d008/CCA/parts.xlsx

LABEL on PCB | DIGIKEY PART # |  | Notes
V_REF | AD587KNZ-ND | IC VREF SERIES 10V 8DIP | voltage regulator to ensure 10V to the bridge
C1,C2 | 478-6065-ND | CAP TANT 47UF 20V 10% RADIAL | noise reduction
+/-15VDC | ED2741-ND | TERMINAL BLOCK 3.5MM 3POS PCB | screw terminals for wire leads
NSTAP, OUTPUT | ARF2037-ND | CONN BNC JACK R/A 75 OHM PCB | BNC connectors for the sensor and the output signal
C3, C5, C6 | 399-13634-1-ND | CAP TANT 1UF 5% 35V RADIAL | noise reduction
C4 | 495-5055-1-ND | CAP FILM 0.1UF 5% 100VDC RADIAL | noise reduction
IN-AMP | AD8429ARZ-ND | IC OPAMP INSTR 3.5MHZ 8SOIC | The amplification is set by R_GAIN, where R_GAIN = 6 kOhm/(Gain -1)
R_GAIN | 15.0XBK-ND | RES 15 OHM 1/4W 1% AXIAL | NSTAPs typically use a gain of ~400 but feel free to experiment and choose what works best for range of data acquisition
L1, L2 | M10080-ND | FIXED IND 1UH 1.07A 70 MOHM TH | noise reduction
R1, R2 | A105892CT-ND | RES 49.9 OHM 1/4W 0.1% AXIAL | noise reduction
R_TOP_1, R_TOP_2 | 3.3KADCT-ND | RES 3.3K OHM 1/4W 0.1% AXIAL | top resistors of the wheatstone bridge -- 3.3k Ohm was determined by trial and error (want a value high enough that the wire doesn't burn but low enough to be sensitive )
R_BAL | 180ADCT-ND | RES 180 OHM 1/4W 0.1% AXIAL | The total balance resistance is (R_BAL + TRIMPOT) so for our case we used 180 ohm + (5 to 200 ohm)
TRIMPOT | 490-2879-ND | TRIMMER 200 OHM 0.5W TH | The same series also have 50, 100 ohm trim pots available
- | 285-1760-ND | PWR SPLY MEDICAL +15V/-15V 15W | this was the AC/DC converter we used
