d008/CCA/NSTAP.brd

## EAGLE design NSTAP.brd (2020-06-23)

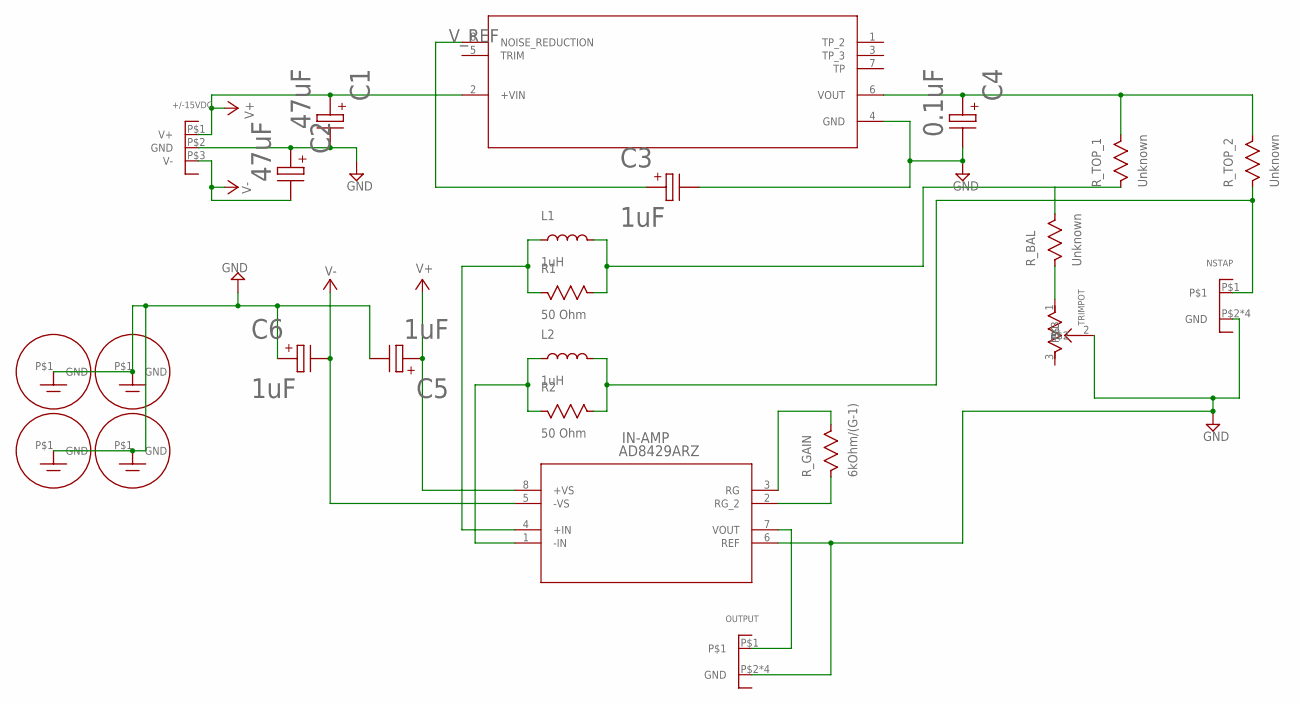
[picture p1: schematic NSTAP.sch]

Parts:
+/-15VDC: CONNECTOR_3COND""; SCREW_TERM3X-OST
C1, C2: 47uF; BRD_0075X050-P
C3, C5, C6: 1uF; BRD_0075X025-P
C4: 0.1uF; BRD_0075X050-P
IN-AMP: AD8429ARZ; R_8
L1, L2: 1uH; BRD_0075X150
NSTAP: CONNECTOR_COAXAMPHENOL-2037; BNC_AMPHENOL
OUTPUT: CONNECTOR_COAXAMPHENOL-2037; BNC_AMPHENOL
R1, R2: 50 Ohm; BRD_0075X100
R_BAL: Unknown; BRD_0075X100
R_GAIN: 6kOhm/(G-1); BRD_0075X100
R_TOP_1, R_TOP_2: Unknown; BRD_0075X100
TRIMPOT: TRIM_POT
U$1, U$2, U$3, U$4: GND-SCREW4MM; GND-SCREW_4MM
V_REF: AD587KNZ; N_8

Connections:
GND: +/-15VDC.P$2 (GND), C1.P$2, C2.P$1, C3.P$2, C4.P$2, C5.P$2, C6.P$1, IN-AMP.6 (REF), NSTAP.P$2 (GND), NSTAP.P$3 (GND), NSTAP.P$4 (GND), NSTAP.P$5 (GND), OUTPUT.P$2 (GND), OUTPUT.P$3 (GND), OUTPUT.P$4 (GND), OUTPUT.P$5 (GND), TRIMPOT.2, U$1.P$1, U$2.P$1, U$3.P$1, U$4.P$1, V_REF.4 (GND)
unnamed: C3.P$1, V_REF.8 (NOISE_REDUCTION)
unnamed: R_BAL.P$1, TRIMPOT.1
unnamed: IN-AMP.3 (RG), R_GAIN.P$2
unnamed: IN-AMP.2 (RG_2), R_GAIN.P$1
unnamed: IN-AMP.7 (VOUT), OUTPUT.P$1
unnamed: IN-AMP.4 (+IN), L1.P$1, R1.P$1
unnamed: IN-AMP.1 (-IN), L2.P$1, R2.P$1
unnamed: L2.P$2, NSTAP.P$1, R2.P$2, R_TOP_2.P$1
unnamed: C4.P$1, R_TOP_1.P$2, R_TOP_2.P$2, V_REF.6 (VOUT)
unnamed: L1.P$2, R1.P$2, R_BAL.P$2, R_TOP_1.P$1
V+: +/-15VDC.P$1 (V+), C1.P$1, C5.P$1, IN-AMP.8 (+VS), V_REF.2 (+VIN)
V-: +/-15VDC.P$3 (V-), C2.P$2, C6.P$2, IN-AMP.5 (-VS)

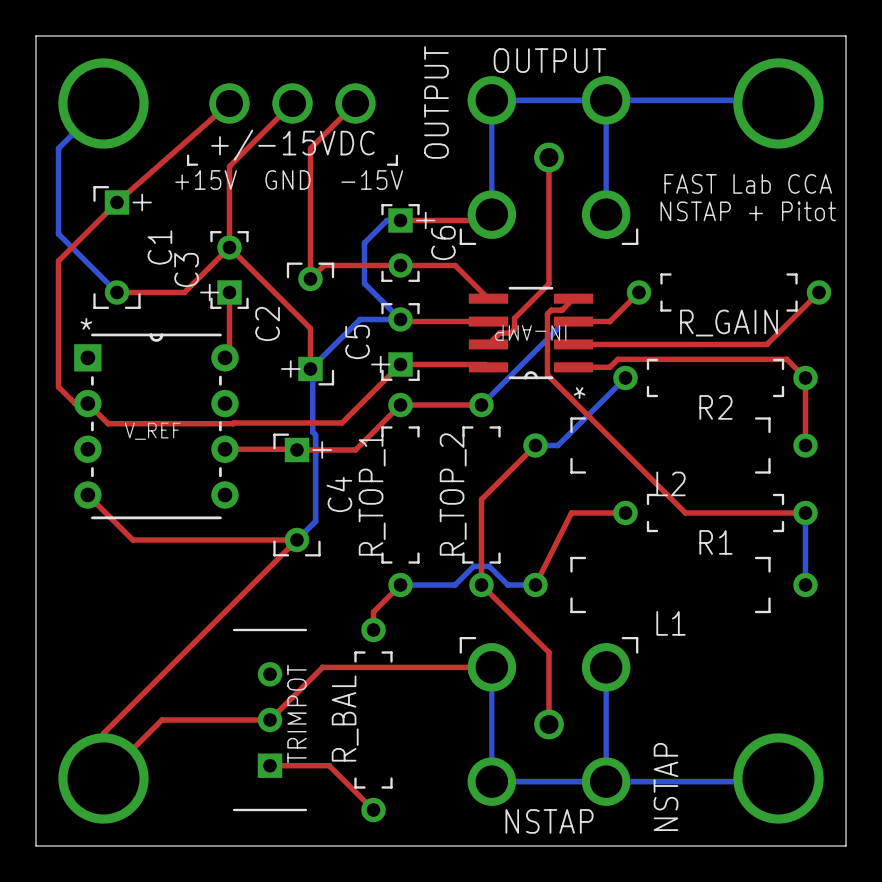
[picture p2: board NSTAP.brd from above]

Board: 2 copper layers, 45.0 x 45.0 mm, 24 parts (0 on the bottom side), 13 nets.
